rahulgkatre/kneebrace/(commit log)

2023-03-05 Added working code for reading IMU
2023-03-31 Switching to Arduino
2023-04-03 Added c3 d3 for plotting locally, need to fix JS
    [BNO08X.ino, Filesystem.ino, KneeBrace.ino, Network.ino, Webserver.ino]
2023-04-04 Fixed plotting, added more BNO08X reports
    [BNO08X.ino, Filesystem.ino, KneeBrace.ino, Network.ino, Webserver.ino]
2023-04-16 Added buttons functionality
2023-04-17 Added more haptic buttons
